arthurgritzky/Rotary-Tumbler/README.md

# Rotary-Tumbler
This repo contains the code, 3D-files and assembly guide for a 3D printed rotary tumbler.

https://github.com/user-attachments/assets/90043965-0956-482e-ac33-672fab636f33

## Introduction

Rotary tumblers are a fun and versatile addition to your manufacturing toolkit. They can be used for sanding and polishing parts, which is particularly useful for preparing 3D-printed components for painting. Other popular applications include the recreational polishing of stones, removing rust, or cleaning paint off small metal parts. These capabilities make rotary tumblers a valuable tool for your future projects.
The inspiration for building this rotary tumbler was driven primarily by the idea of creating something functional from salvaged materials. Most of the required parts can be repurposed from an old 3D printer, making this a cost-effective and sustainable project. Rather than letting unused components sit idle in storage, this project gives them a new purpose, turning leftover parts into a practical and productive tool.

## Design Choices

The core of this tumbler's design revolves around a large pickle jar that serves as the drum, which is filled with an abrasive medium and spun by two rollers. Using a glass jar instead of a 3D-printed chamber ensures water tightness and durability. The decision to build a rotary tumbler, rather than a vibratory one, was based on simplicity. A rotary design is easier to construct, less demanding on components, and well-suited to extended operation.

This project takes a recycling-first approach, which led to the use of stepper motors for driving the rollers. While geared DC motors are generally better suited for this application, stepper motors were selected because they were already on hand. They are easy to control, excel at low RPM applications, and deliver high torque without the need for additional gearboxes. This approach also eliminates the need for a pulley system, which reduces cost and complexity.

Driving both rollers is a critical aspect of this design. Without this feature, the jar's high mass, smooth surface, and limited contact area can cause it to slip rather than roll. By directly coupling the stepper motors to the rollers, the tumbler achieves reliable rotation and eliminates potential issues with gear wear, ensuring the machine can operate for long periods without maintenance. The overall goal of this design is for the jar's contents to wear down, not the tumbler itself.

## Controlling 
The stepper motors in this rotary tumbler are controlled using a CNC-Shield mounted on an Arduino UNO, equipped with two A4988 stepper motor drivers positioned on the X and Y axes. To ensure smooth and precise motion, 1/8 microstepping has been enabled on both motors. This setup offers a simple yet powerful control solution, allowing for precise speed adjustments and ensuring reliable operation over extended periods.
Using an Arduino UNO paired with a CNC-Shield makes the control system modular and easily replicable for other makers. The A4988 drivers are a cost-effective choice, providing the necessary torque and control for low-RPM applications without requiring complex programming or additional hardware. By leveraging this setup, the tumbler achieves consistent performance and can be easily tuned or modified as needed. The entire system is powered by a 12V, 2A power supply salvaged from an LED strip, making it a cost-effective and accessible choice. To safely power the Arduino UNO, an LM2596 buck converter is used to step the 12V supply down to 6V, which is then fed into the Arduino's input jack.

## Bill of Materials

* 2x stepper motor NEMA 17
* 2x rod (8mmx225mm) // I used a threaded rod 
* 2x shaft couplings (5mm to 8mm)
* 13x socket head screw M3x8
* 59x philips head screw M4x16
* 59x M4 hex nut 
* 5x  M3 hex nut
* 6x set screw M5x8
* 4x 608 bearing link
* 1x Arduino Uno
* 1x CNC-Shield with stepper driver
* 1x LM 2596 Buck converter or another power supply to power the Arduino
* 1x Power supply 12V with around 2 A

For the print files please check out: https://makerworld.com/en/models/865983#profileId-817201

## Assembly
### Step 1:


### Step 2:


### Step 3:


### Step 4:


### Step 5:


### Step 6:


### Step 7:


### Step 8:


### Step 9:


### Step 10:


### Step 11:


### Step 12:


### Step 13:


### Step 14:


### Step 15:


### Step 16:


### Step 17:


### Step 18:


### Step 19:
