arthurgritzky/Rotary-Tumbler/CAD/Front.SLDPRT

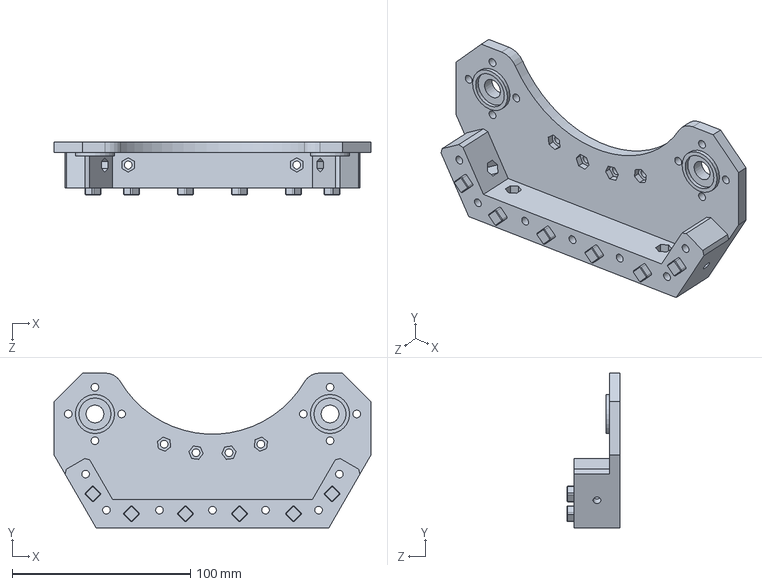
[picture p1: CAD file, 2024-12-12]
CAD/Front.SLDPRT
178.0 x 87.0 x 30.0 mm
