arthurgritzky/Rotary-Tumbler/CAD/Motor_Mount.SLDPRT

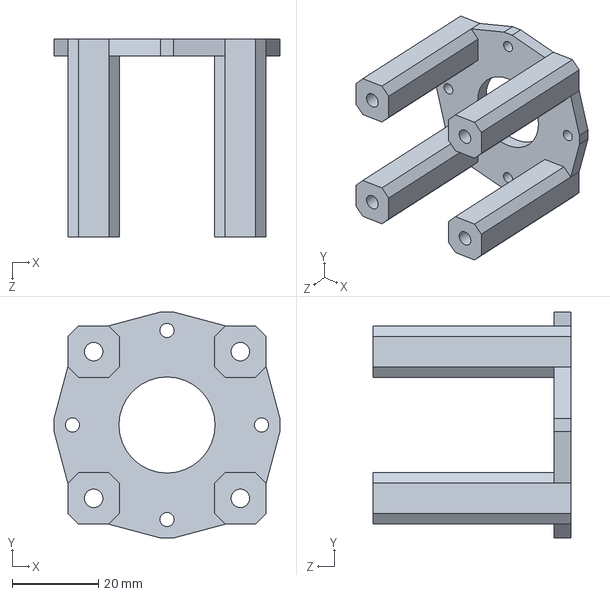
[picture p2: CAD file, 2024-12-12]
CAD/Motor_Mount.SLDPRT
52.4 x 52.4 x 46.0 mm
