arthurgritzky/Rotary-Tumbler/CAD/Spacer.SLDPRT

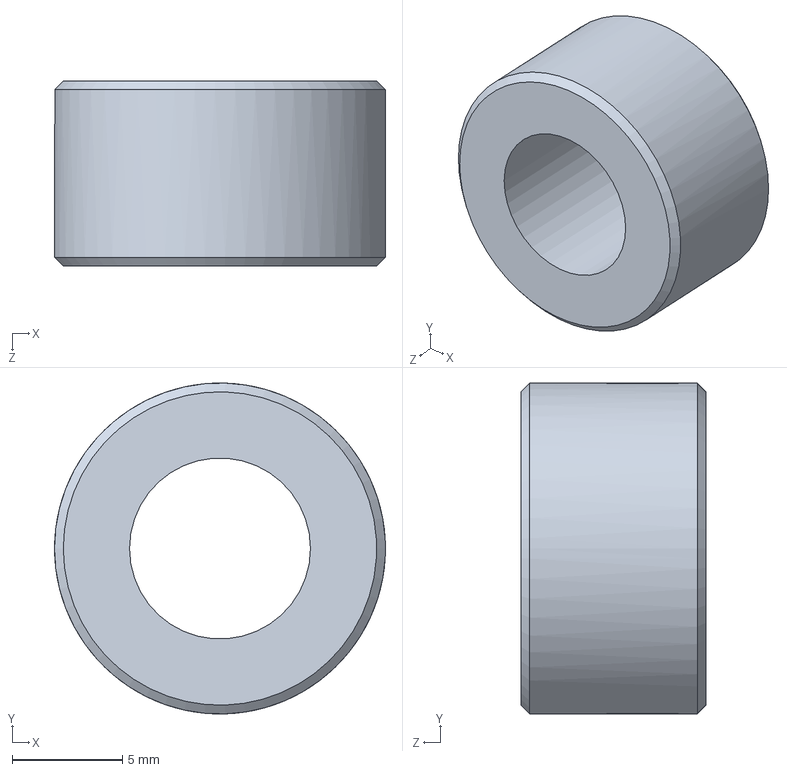
[picture p3: CAD file, 2024-12-12]
CAD/Spacer.SLDPRT
15.0 x 15.0 x 8.40 mm
