arthurgritzky/Rotary-Tumbler/CAD/Bearinghousing.SLDPRT

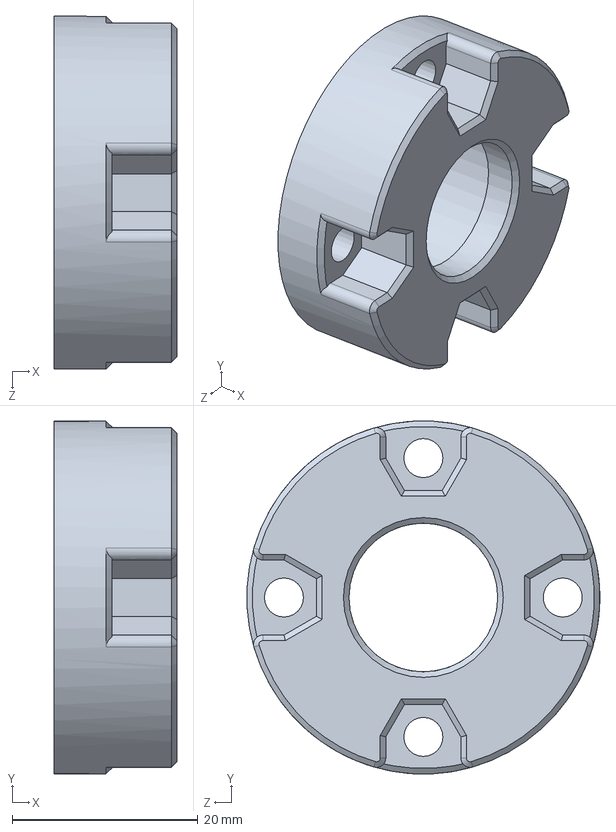
[picture p4: CAD file, 2024-12-12]
CAD/Bearinghousing.SLDPRT
13.2 x 38.0 x 38.0 mm
