arthurgritzky/Rotary-Tumbler/CAD/Electronic_cover.SLDPRT

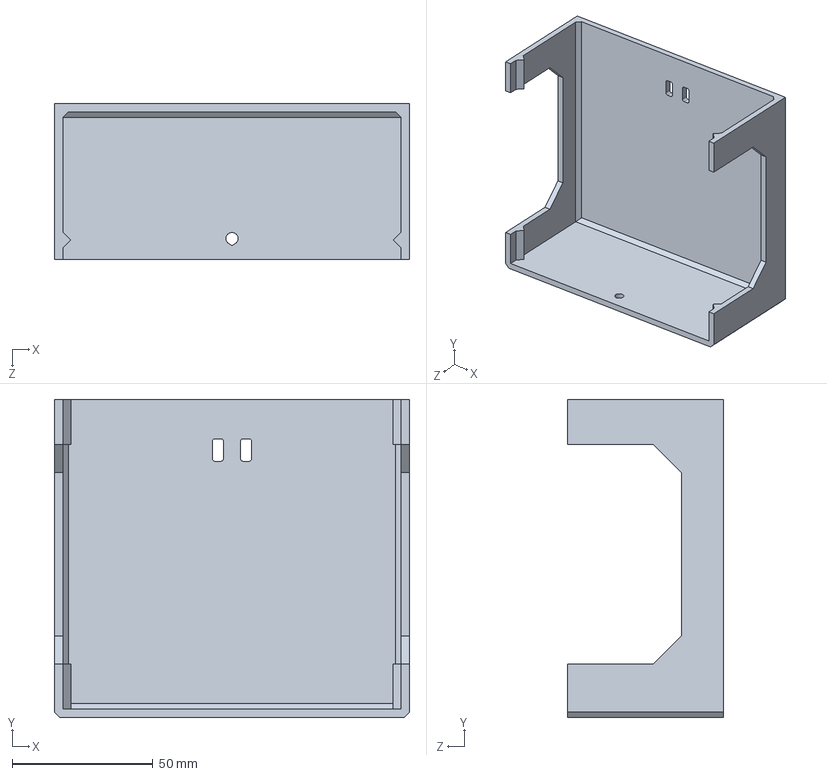
[picture p5: CAD file, 2024-12-12]
CAD/Electronic_cover.SLDPRT
126.0 x 113.0 x 55.5 mm
