arthurgritzky/Rotary-Tumbler/CAD/Jar.SLDPRT

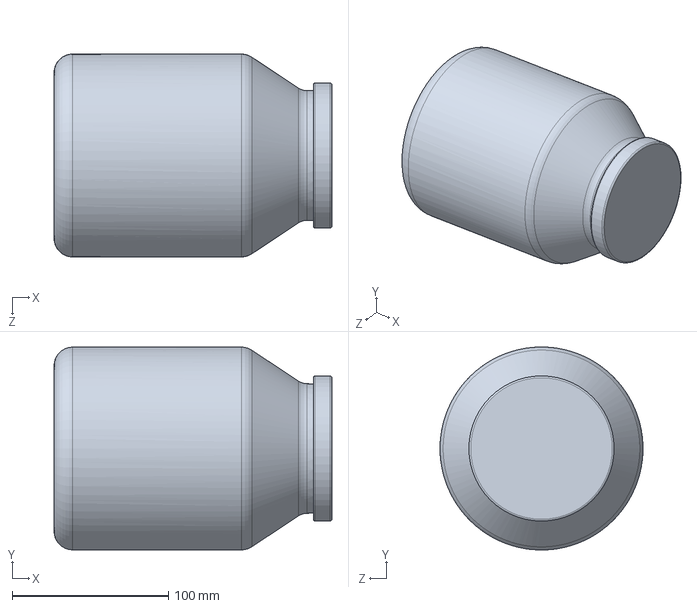
[picture p6: CAD file, 2024-12-12]
CAD/Jar.SLDPRT
178.0 x 129.9 x 130.0 mm
