arthurgritzky/Rotary-Tumbler/CAD/Foot.SLDPRT

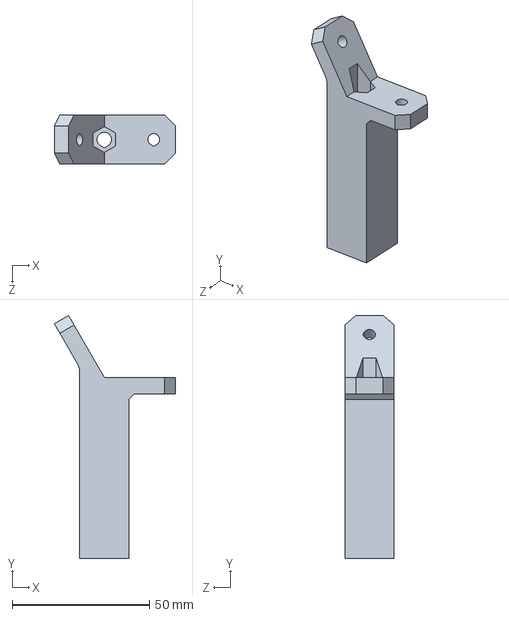
[picture p7: CAD file, 2024-12-12]
CAD/Foot.SLDPRT
44.2 x 88.5 x 18.0 mm
