arthurgritzky/Rotary-Tumbler/CAD/LM2596 DC to DC Buck Converter.SLDPRT

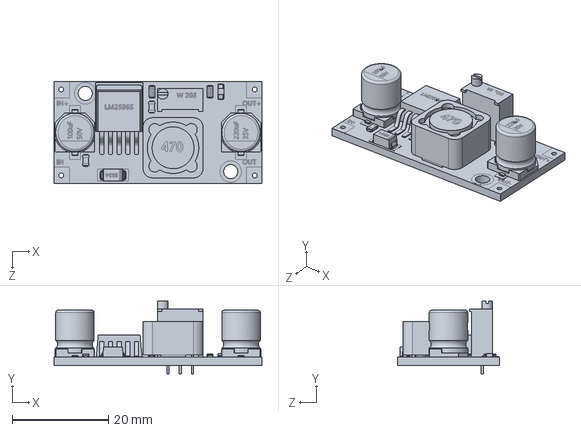
[picture p8: CAD file, 2024-12-12]
CAD/LM2596 DC to DC Buck Converter.SLDPRT
43.2 x 15.1 x 21.2 mm
