arthurgritzky/Rotary-Tumbler/CAD/Shaft.SLDPRT

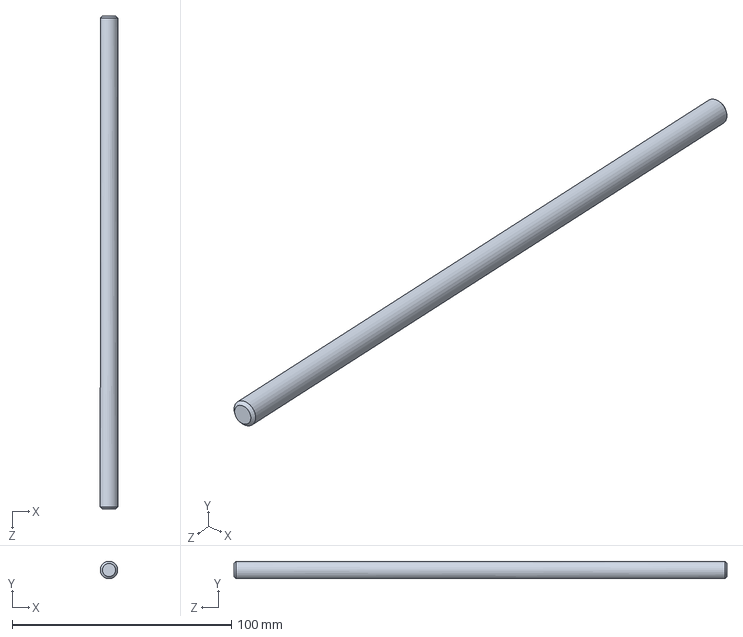
[picture p9: CAD file, 2024-12-12]
CAD/Shaft.SLDPRT
8.00 x 7.99 x 225.0 mm
