arthurgritzky/Rotary-Tumbler/CAD/Coupling.SLDPRT

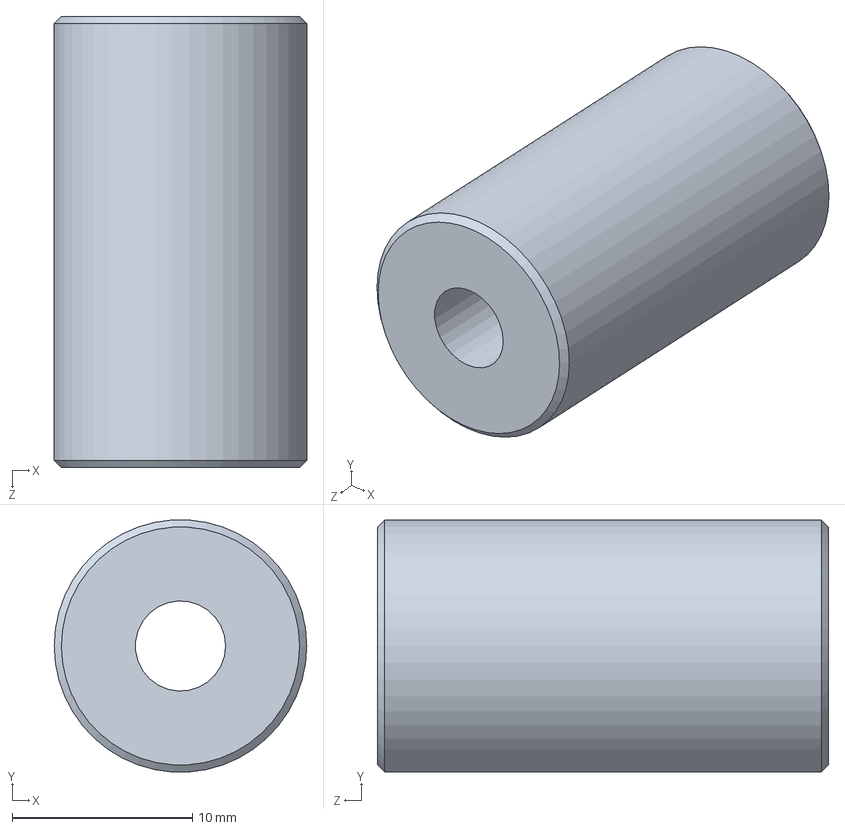
[picture p10: CAD file, 2024-12-12]
CAD/Coupling.SLDPRT
14.0 x 14.0 x 25.0 mm
