arthurgritzky/Rotary-Tumbler/CAD/Bearing_608.SLDPRT

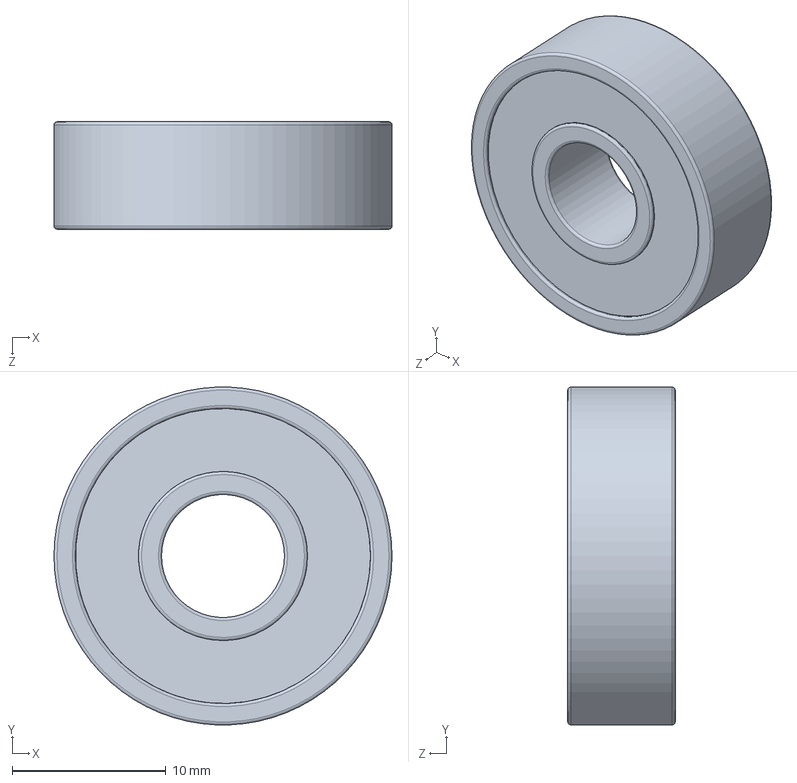
[picture p11: CAD file, 2024-12-12]
CAD/Bearing_608.SLDPRT
22.0 x 22.0 x 7.00 mm
