arthurgritzky/Rotary-Tumbler/CAD/Bridge.SLDPRT

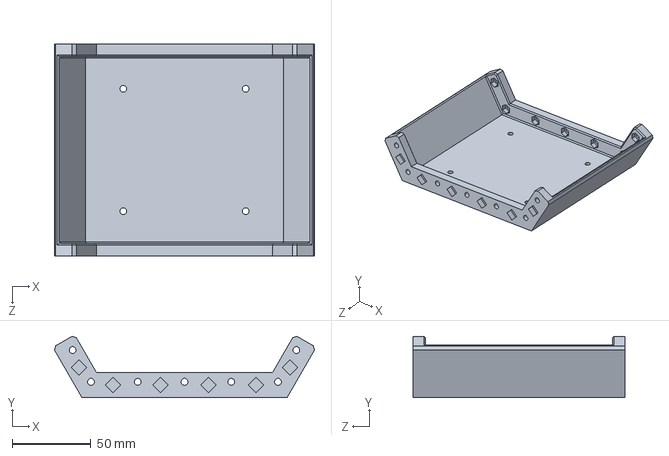
[picture p12: CAD file, 2024-12-12]
CAD/Bridge.SLDPRT
165.6 x 39.0 x 135.0 mm
