arthurgritzky/Rotary-Tumbler/CAD/Front_Rollerholder.SLDPRT

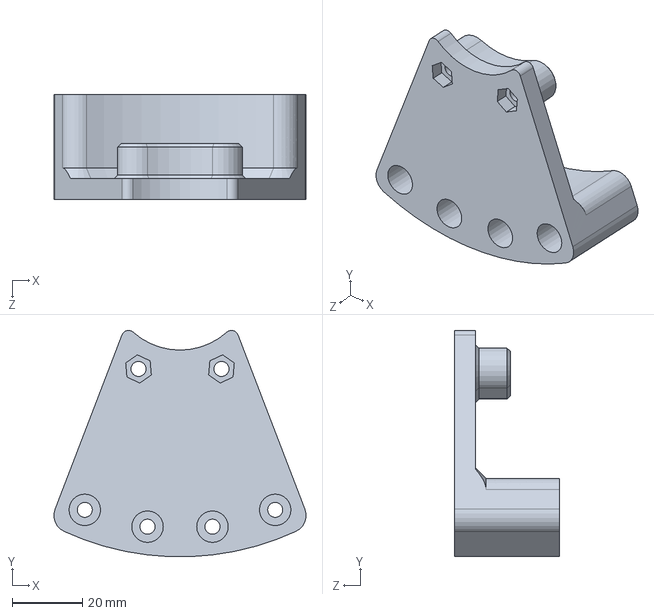
[picture p13: CAD file, 2024-12-12]
CAD/Front_Rollerholder.SLDPRT
71.9 x 64.6 x 30.0 mm
