arthurgritzky/Rotary-Tumbler/CAD/Electronic_mounting_plate_V2.SLDPRT

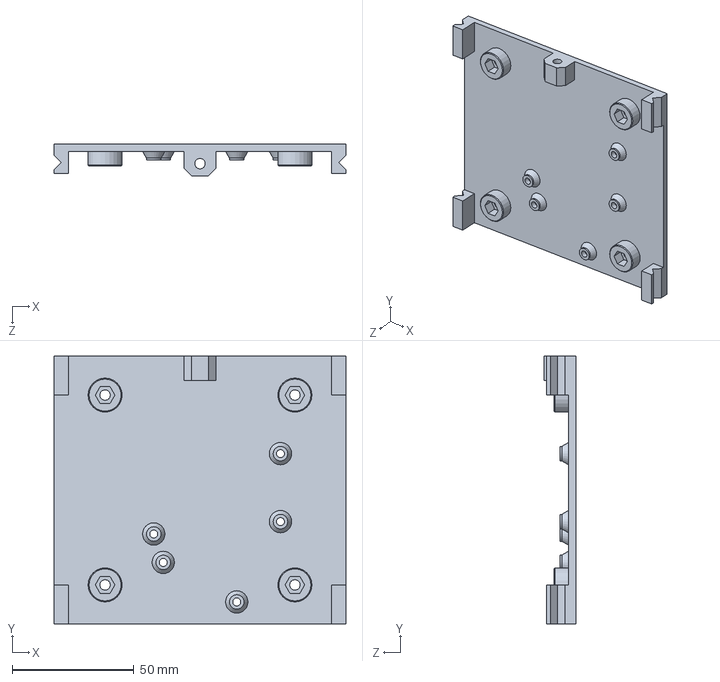
[picture p14: CAD file, 2024-12-12]
CAD/Electronic_mounting_plate_V2.SLDPRT
120.0 x 110.0 x 13.0 mm
