arthurgritzky/Rotary-Tumbler/CAD/Back.SLDPRT

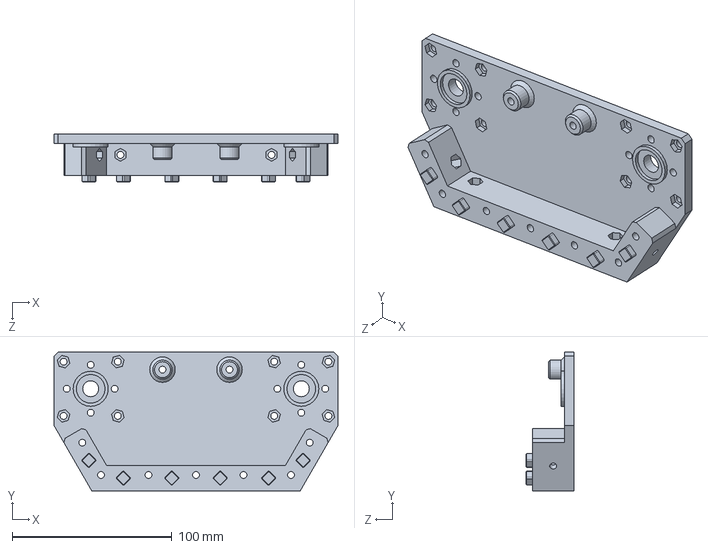
[picture p15: CAD file, 2024-12-12]
CAD/Back.SLDPRT
178.0 x 87.0 x 30.0 mm
