arthurgritzky/Rotary-Tumbler/CAD/Roll.SLDPRT

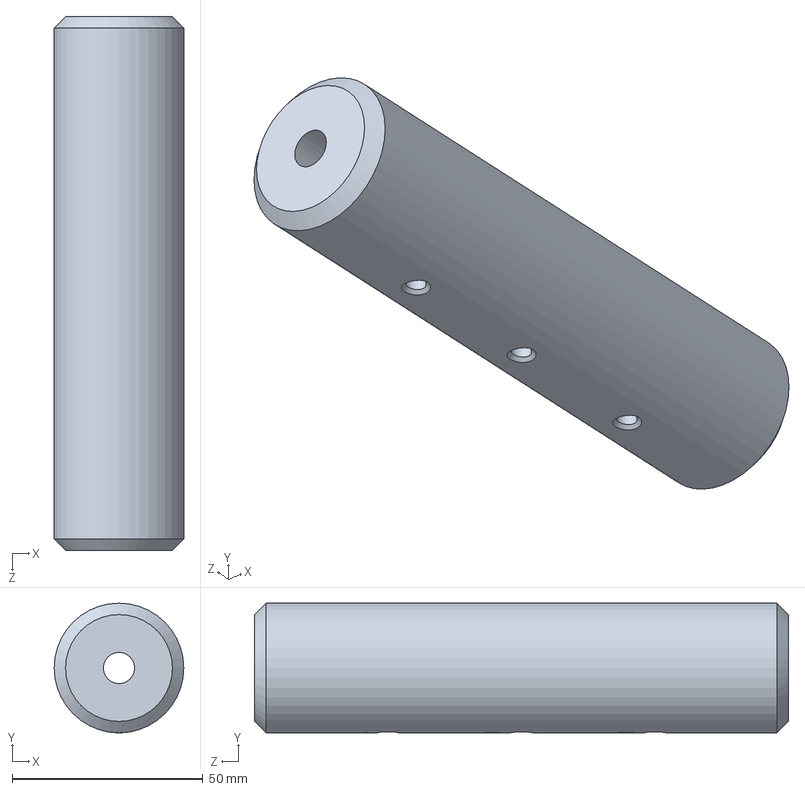
[picture p16: CAD file, 2024-12-12]
CAD/Roll.SLDPRT
34.0 x 34.0 x 140.0 mm
