arthurgritzky/Rotary-Tumbler/CAD/Arduino_Uno_CNC_Shield_V3.SLDPRT

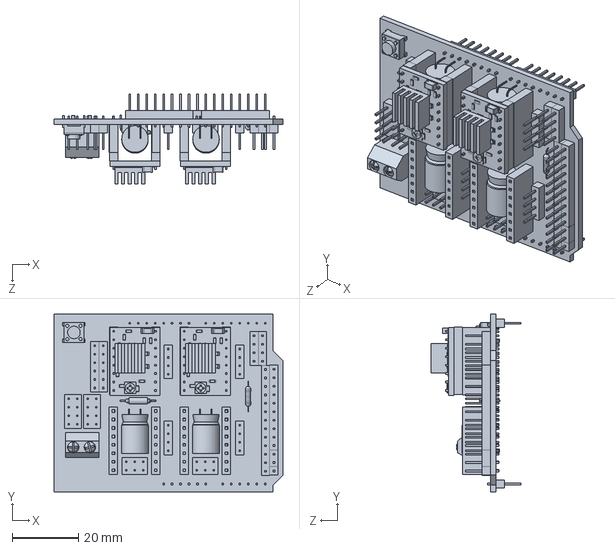
[picture p17: CAD file, 2024-12-12]
CAD/Arduino_Uno_CNC_Shield_V3.SLDPRT
69.0 x 53.5 x 27.1 mm
